paulampmkelly/STEM-Ensemble/AI_StoryTeller_Bot/KiCAD_PCB_Design_Files/3d_models/CUI_DEVICES_SJ-3523-SMT-TR/CUI_DEVICES_SJ-3523-SMT-TR.step

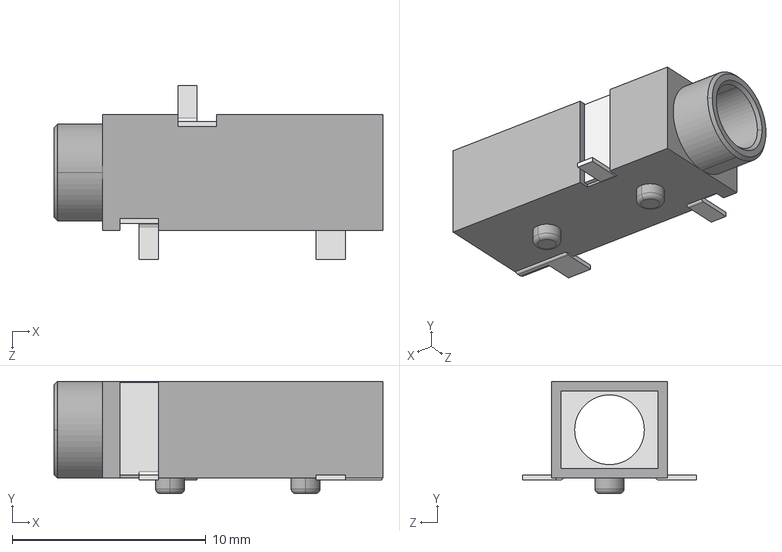
[picture p1: CAD file, 2023-09-07]
AI_StoryTeller_Bot/KiCAD_PCB_Design_Files/3d_models/CUI_DEVICES_SJ-3523-SMT-TR/CUI_DEVICES_SJ-3523-SMT-TR.step
17.0 x 5.80 x 9.00 mm
