paulampmkelly/STEM-Ensemble/AI_StoryTeller_Bot/KiCAD_PCB_Design_Files/Board_Assembly_Info/Kicad_Files/Pi_HAT.kicad_pcb

## KiCad design AI_StoryTeller_Bot/KiCAD_PCB_Design_Files/Board_Assembly_Info/Kicad_Files/Pi_HAT.kicad_pcb (2023-09-07)

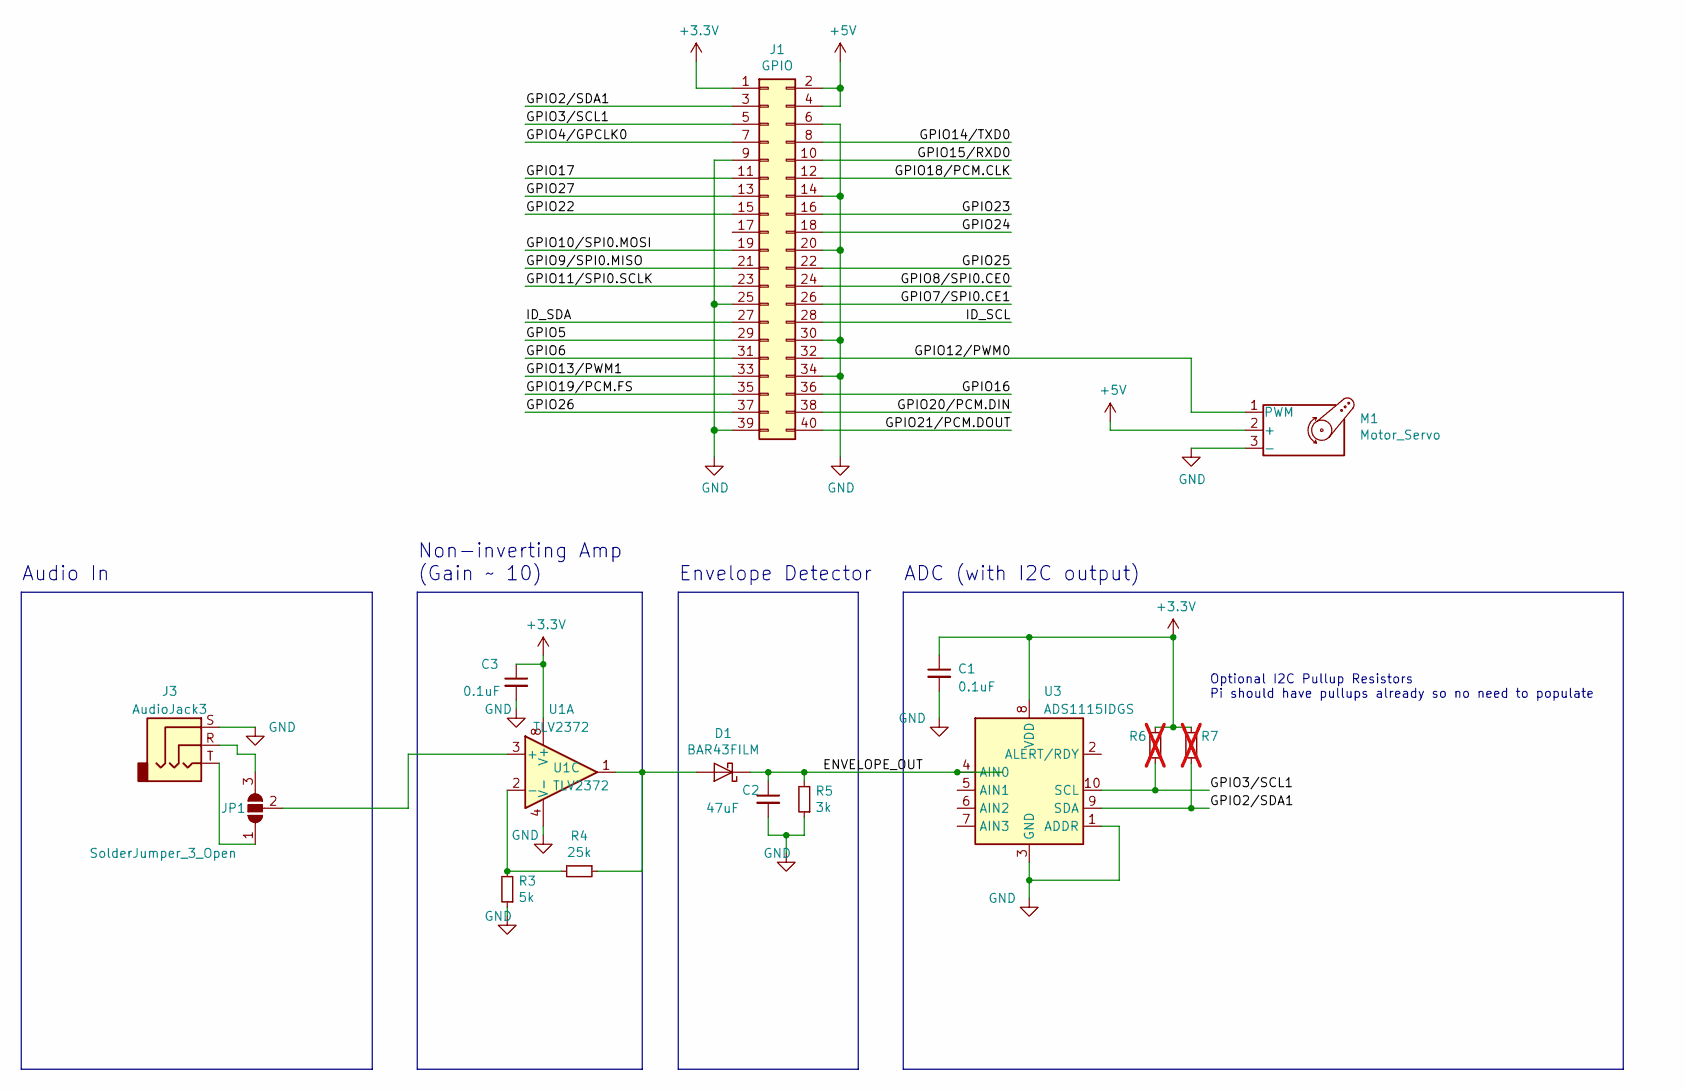
[picture p2: schematic Pi_HAT.kicad_sch, e-NT Mouth Control PCB]

Parts:
C1, C3: 0.1uF; C_0603_1608Metric_Pad1.08x0.95mm_HandSolder
C2: 47uF; C_1206_3216Metric
D1: BAR43FILM; SOT-23
J1: GPIO; PinSocket_2x20_P2.54mm_Vertical
J3: AudioJack3; Jack_3.5mm_CUI_SJ-3523-SMT_Horizontal
JP1: SolderJumper_3_Open; SolderJumper-3_P2.0mm_Open_TrianglePad1.0x1.5mm_NumberLabels
M1: Motor_Servo; JST_PH_S3B-PH-K_1x03_P2.00mm_Horizontal
R3: 5k; R_0603_1608Metric
R4: 25k; R_0603_1608Metric
R5: 3k; R_0603_1608Metric
R6, R7: R_Small; R_0402_1005Metric_Pad0.72x0.64mm_HandSolder; not fitted
U1: TLV2372; SOIC-8_3.9x4.9mm_P1.27mm
U3: ADS1115IDGS; TSSOP-10_3x3mm_P0.5mm

Connections:
+3V3: C1.1, C3.1, J1.1, R6.1, R7.1, U1.8 (V+), U3.8 (VDD)
+5V: J1.2, J1.4, M1.2 (+)
/ENVELOPE_OUT: C2.1, D1.3 (K), R5.2, U3.4 (AIN0)
/GPIO2/SDA1: J1.3, R7.2, U3.9 (SDA)
/GPIO3/SCL1: J1.5, R6.2, U3.10 (SCL)
/GPIO4/GPCLK0: J1.7
/GPIO5: J1.29
/GPIO6: J1.31
/GPIO7/SPI0.CE1: J1.26
/GPIO8/SPI0.CE0: J1.24
/GPIO9/SPI0.MISO: J1.21
/GPIO10/SPI0.MOSI: J1.19
/GPIO11/SPI0.SCLK: J1.23
/GPIO12/PWM0: J1.32, M1.1 (PWM)
/GPIO13/PWM1: J1.33
/GPIO14/TXD0: J1.8
/GPIO15/RXD0: J1.10
/GPIO16: J1.36
/GPIO17: J1.11
/GPIO18/PCM.CLK: J1.12
/GPIO19/PCM.FS: J1.35
/GPIO20/PCM.DIN: J1.38
/GPIO21/PCM.DOUT: J1.40
/GPIO22: J1.15
/GPIO23: J1.16
/GPIO24: J1.18
/GPIO25: J1.22
/GPIO26: J1.37
/GPIO27: J1.13
/ID_SCL: J1.28
/ID_SDA: J1.27
GND: C1.2, C2.2, C3.2, J1.6, J1.9, J1.14, J1.20, J1.25, J1.30, J1.34, J1.39, J3.S, M1.3 (-), R3.1, R5.1, U1.4 (V-), U3.1 (ADDR), U3.3 (GND)
unnamed: D1.1 (A), R4.1, U1.1
unnamed: J3.T, JP1.1 (A)
unnamed: J3.R, JP1.3 (B)
unnamed: JP1.2 (C), U1.3 (+)
unnamed: R3.2, R4.2, U1.2 (-)

Notes on the sheet:
Non-inverting Amp (Gain ~ 10)
Envelope Detector
ADC (with I2C output)
Audio In
Optional I2C Pullup Resistors Pi should have pullups already so no need to populate

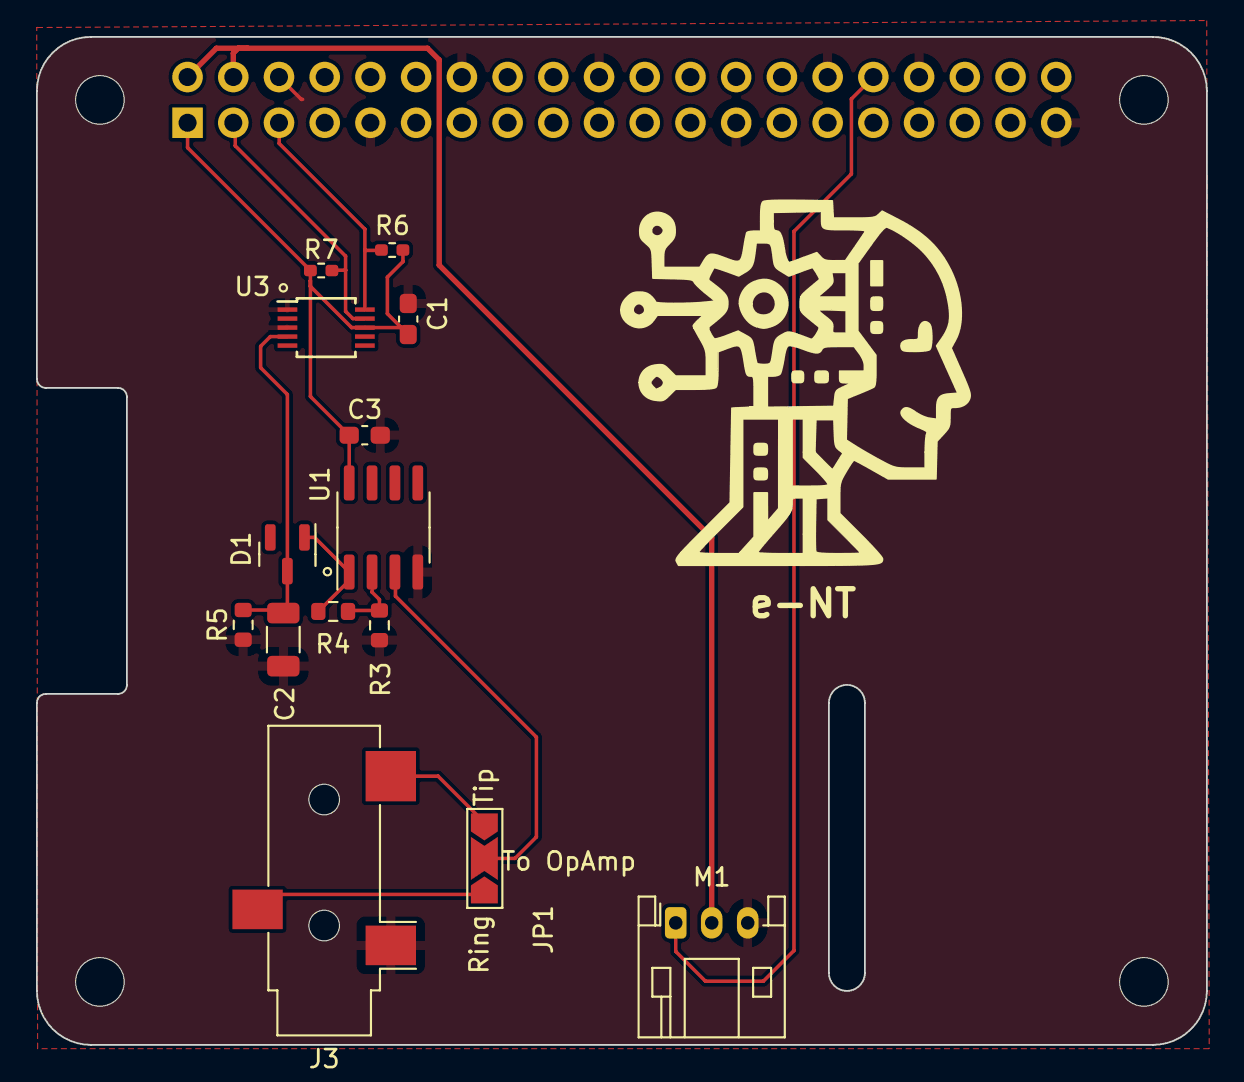
[picture p3: board Pi_HAT.kicad_pcb from above]

Board: 2 copper layers, 65.0 x 56.0 mm, 19 parts (1 on the bottom side), 12 nets.

Other parts of the board:
MH1, MH2, MH3, MH4: MountingHole_2.7mm_M2.5
